Scott216/Moover_Countdown_Clock/ReadMe.md

Moover Countdown Clock
======================
Displays hours, minutes, seconds countdown to next Moover arrival time.  Moover comes at 20 and 50 past the hour in the morning. Only runs on weekends and holidays.  Sketch has calculations for Thanksgiving, Christmas, MLK, and President's week.
When countdown reaches two minutes, a two minute warning will sound.  When it reaches zero and Moover has arrived sound will play and a bus will scroll across the screen.
Only plays sound in the morning.  <br>

Use real time clock to track the time.  <br>
Has two 16x32 RGB displays. [Adafruit's library](http://github.com/adafruit/RGB-matrix-Panel) does not support multiple displays, I used one from [Protonmaster RGB-matrix-Panel](http://github.com/protonmaster/RGB-matrix-Panel0)

BoM 
* 1x Arduino Mega Pro (5V) from [Sparkfun](http://www.sparkfun.com/products/11007)
* 1x [Speaker](http://www.adafruit.com/products/1313) 8 ohm
* 1x [Audio board](http://www.adafruit.com/products/1381) 
* 1x [Audio Amp](http://www.adafruit.com/products/1552) , 2.8 watt
* 2x [RGB LED Displays](http://www.adafruit.com/products/420)  16x32
* 1x [Chrono Dot](http://www.adafruit.com/products/255)  real time clock
* 1x Micro SD card
* 1x 10k volume pot (linear), Digikey PCW1J-C24-CAB103L-ND
* 1x Tinted acrylic, Inventables 24167
* 1x 5v Power supply
* 1x 1/8" acrylic Laser-cut mounting plate [GitHub](http://github.com/Scott216/Moover_Countdown_Clock/blob/master/Drawings/Mounting%20Plate.skp) 
* 12 3mm x 10mm screws to attach displays to mounting plate
* Screws and standoffs for PCBs and speaker
* DC jack for power

Sound of woman announcing Moover: [oddcast.com](http://www.oddcast.com/home/demos/tts/tts_example.php) , Bridget (UK), Effect: Reverb <br>
