Scott216/Moover_Countdown_Clock/Moover_Clock/ReadMe.txt

To Do:

Wiring display to Mega Pro
Disp   Color   Pin
OE  -- Grn  -- 38 
CLK -- Viol -- 12
C   -- Yel  -- 34
A   -- Gray -- 30
B2  -- Brn  -- 29
R2  -- Org  -- 27  
B1  -- Blue -- 26
R1  -- Red  -- 24
ST  -- Brn  -- 36
B   -- Blue -- 32
G2  -- Viol -- 28
G1  -- GRN  -- 25
Gnd -- Blk  -- GND

Sound card to Mega Pro
Audio   Color   Pin
XDCS -- Viol --  8
SDCS -- Yel  --  4
CS   -- Blu  -- 10
RST  -- Brn  --  9
CLK  -- Gray -- 52
MOSI -- Org  -- 51
MISO -- Grn  -- 50
DREQ -- Gray --  3
GND  -- Blk  -- GND
VCC  -- Red  -- 3.3v
