Scott216/Moover_Countdown_Clock/Sounds/ArriveNow.band/Output/arrange_screenshot.tiff

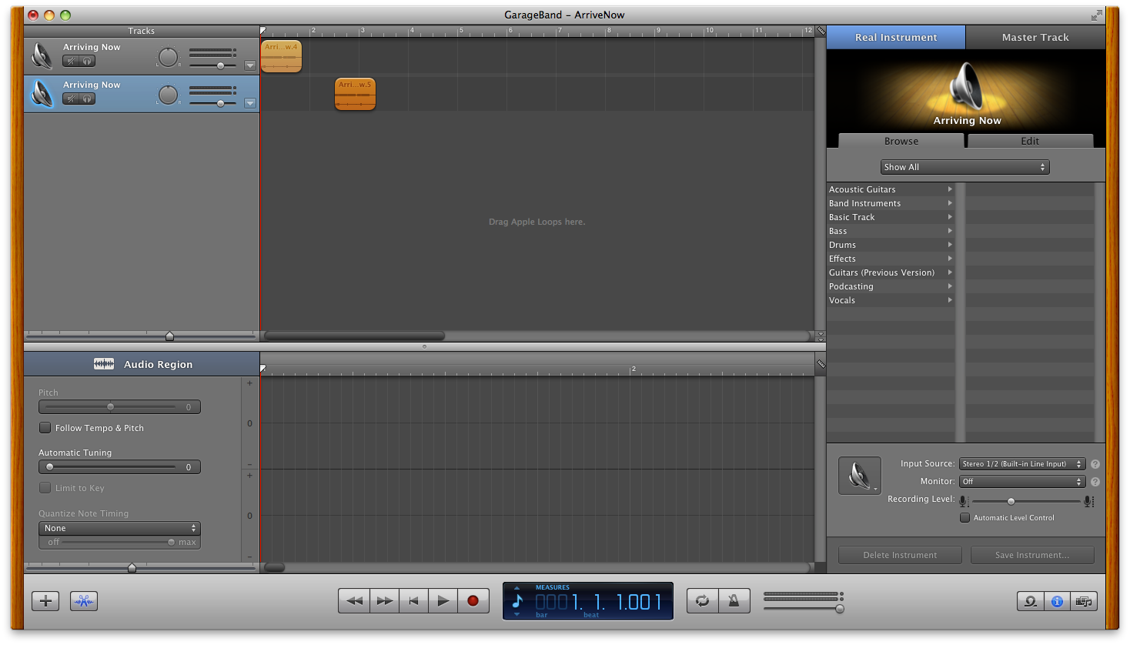
Sounds/ArriveNow.band/Output/arrange_screenshot.tiff
