Scott216/Moover_Countdown_Clock/Sounds/Moover Sound2.band/Output/arrange_screenshot.tiff

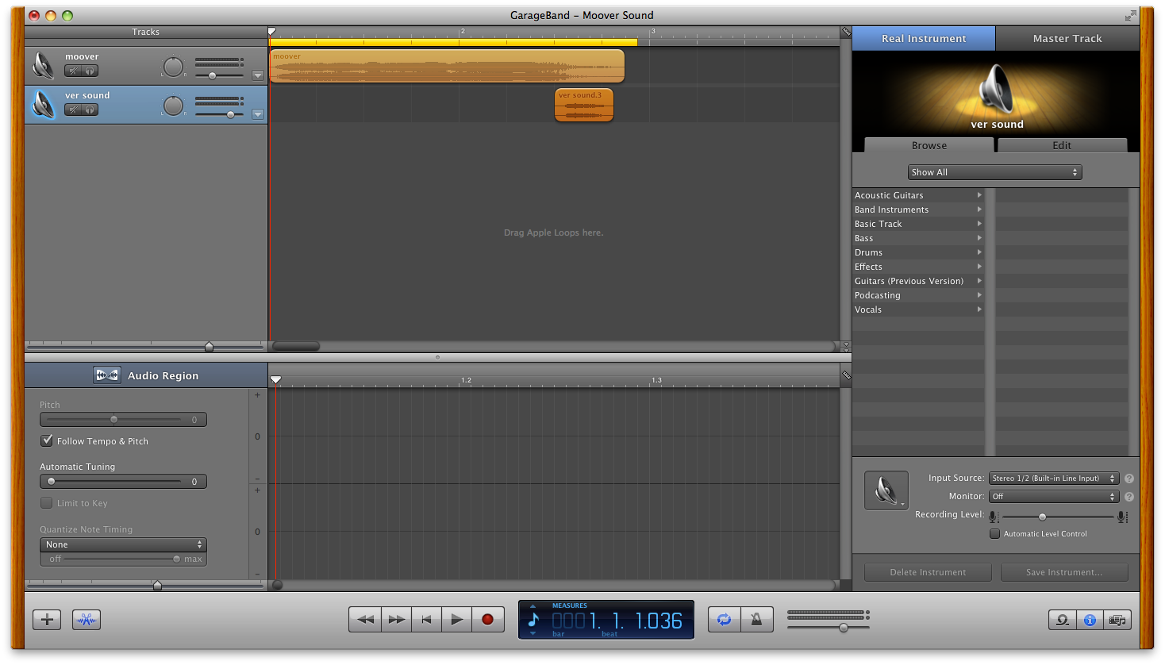
Sounds/Moover Sound2.band/Output/arrange_screenshot.tiff
