Scott216/Moover_Countdown_Clock/Sounds/Moover Sound.band/Output/arrange_screenshot.tiff

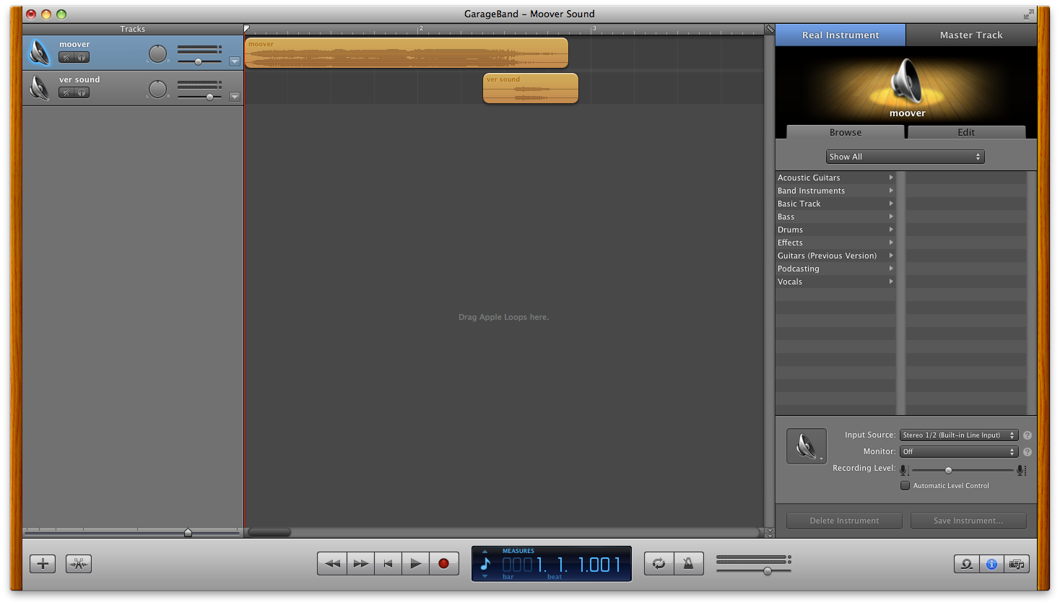
Sounds/Moover Sound.band/Output/arrange_screenshot.tiff
