Scott216/Moover_Countdown_Clock/Sounds/Two Minutes1.band/Output/arrange_screenshot.tiff

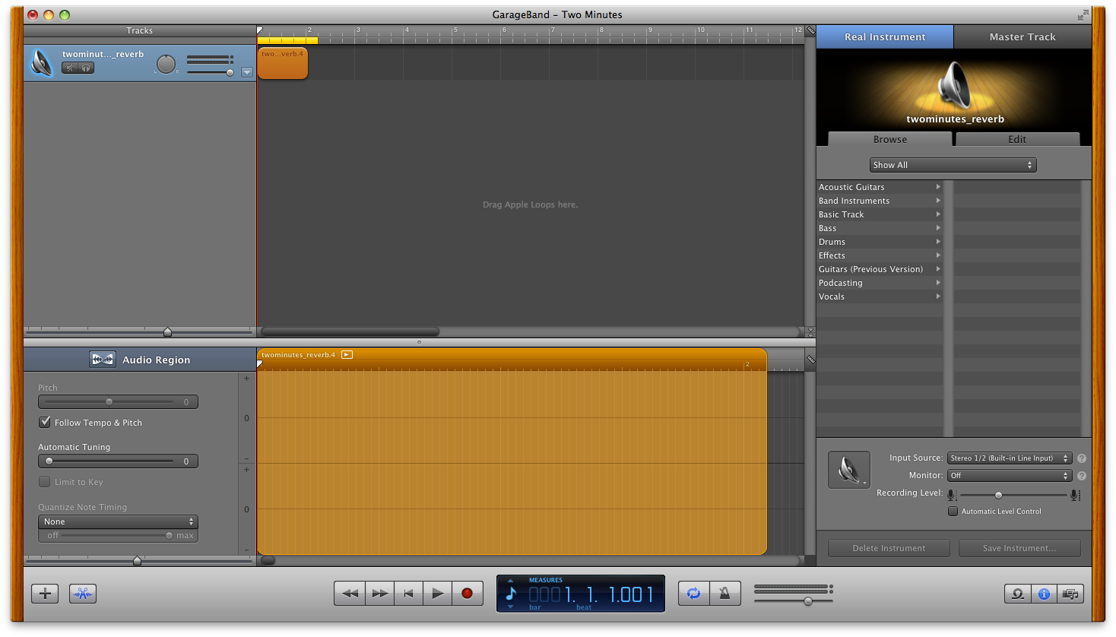
Sounds/Two Minutes1.band/Output/arrange_screenshot.tiff
