Scott216/Moover_Countdown_Clock/(list of files, cad)

Other CAD files:
Drawings/Enclosure.skp
Drawings/Mounting Plate.skp
