Scott216/Moover_Countdown_Clock/(commit log)

2014-01-13 Sketchup drawings
    Drawing for mounting plate and enclosure
    [Enclosure.skp, Mounting Plate.skp]
2014-01-13 Added wiring diagram
2014-01-15 Fixed bugs, enabled daylight savings
    Fixed a few schedule bugs, got daylight savings working
    [Moover_Clock.ino]
2014-02-20 Added display current time
    Displays current time, changed LED colors, added line to enable/disable
    audio amp because it was humming
2014-03-18 v1.50 Fixed daylight saving, fixed couple small bugs
    [Moover_Clock.ino]
2015-01-04 v1.55 fixed overflow bug and added "Happy New Year"
    v1.54 fixed bug that was locking up Arduino - character array was too
    short.
    v1.55 - clock displays “Happy New Year” at beginning of the year
    [Moover_Clock.ino]
